PhillingGod/ti89-titanium--ai-gamepad/docs/jack_board_photo.png

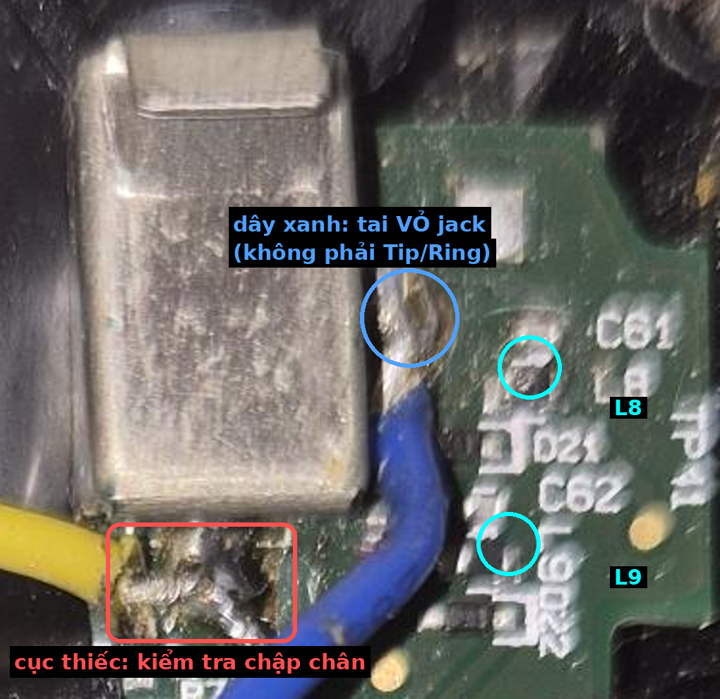
docs/jack_board_photo.png
