PhillingGod/ti89-titanium--ai-gamepad/docs/tip_ring_sleeve.png

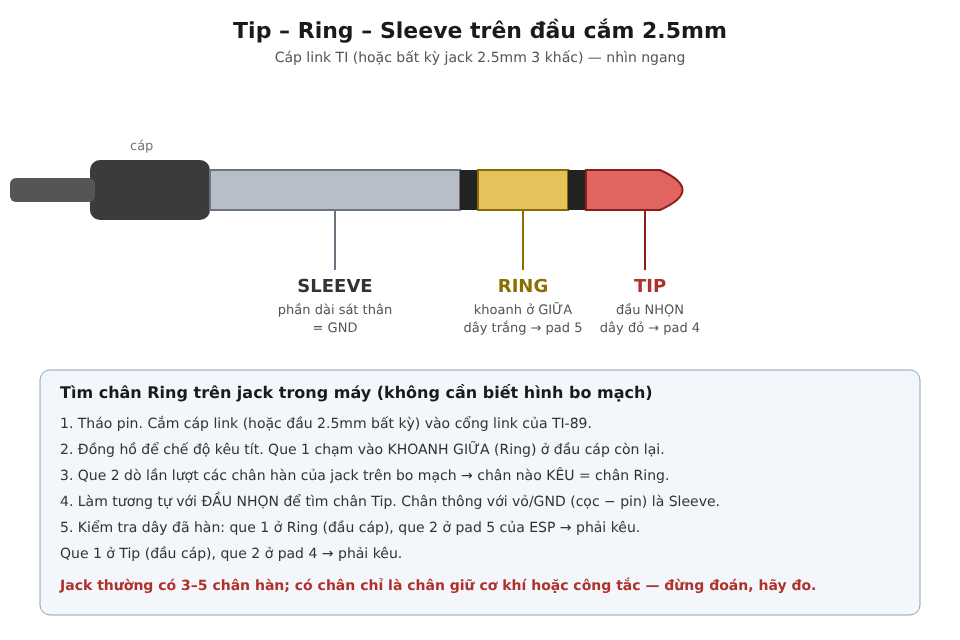
docs/tip_ring_sleeve.png
