PhillingGod/ti89-titanium--ai-gamepad/(commit log)

2026-10-17 Initial commit
    ESP32 firmware, gpt/pad programs, casio() calculator, tools and docs
2026-10-17 Fixed wiring issue
    Removed the two resistors
2026-10-17 No resistor
